freecores/RISCMCU/(list of files, cad)

Other CAD files:
asm/game.obj
asm/calc.obj
