freecores/RISCMCU/documentation/RISCMCU_Presentation.pdf

# Building A RISC Microcontroller in an FPGA

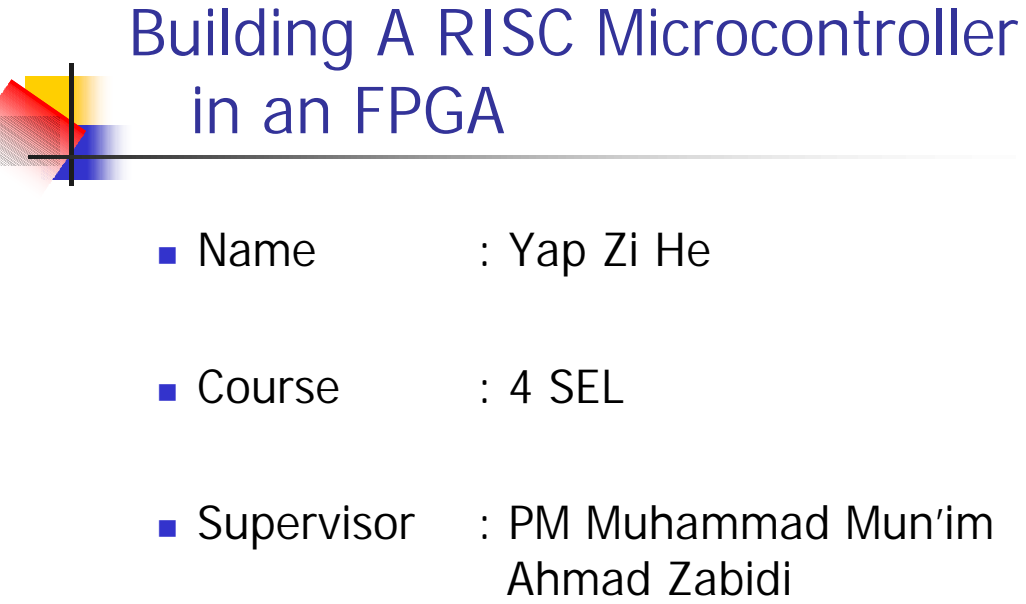
[picture p15: page 1]
n Name; : Yap Zi He; n Course; : 4 SEL; Ahmad Zabidi

n Supervisor : PM Muhammad Mun’im

# Introduction

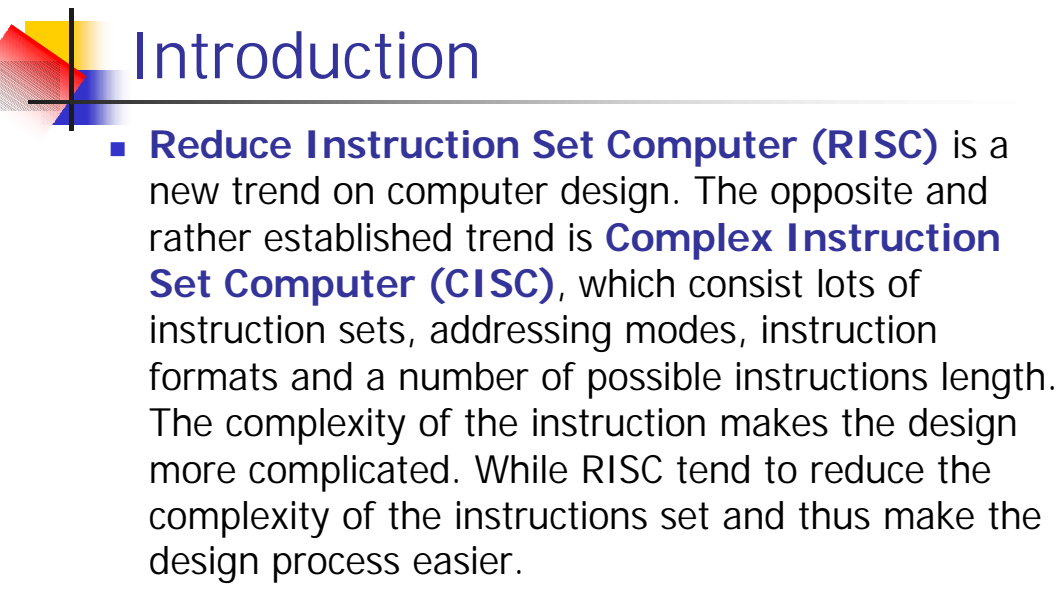
[picture p16: page 2]

n Reduce Instruction Set Computer (RISC) is a
new trend on computer design. The opposite and
rather established trend is Complex Instruction
Set Computer (CISC), which consist lots of
instruction sets, addressing modes, instruction
formats and a number of possible instructions length.
The complexity of the instruction makes the design
more complicated. While RISC tend to reduce the
complexity of the instructions set and thus make the
design process easier.

# Objectives

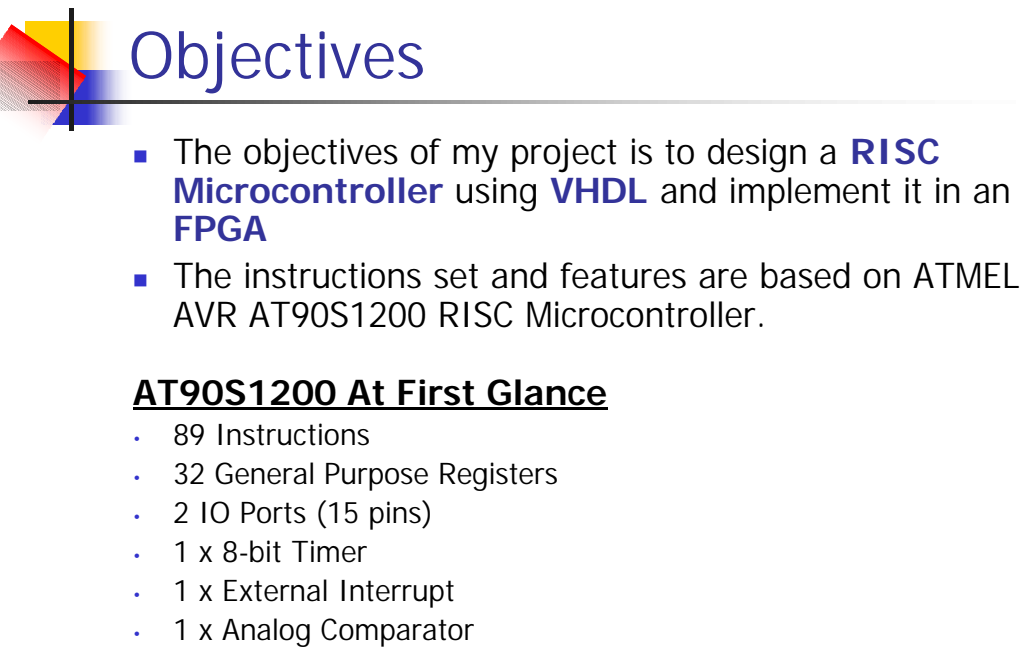
[picture p17: page 3]

n The objectives of my project is to design a RISC
Microcontroller using VHDL and implement it in an
FPGA
n The instructions set and features are based on ATMEL
AVR AT90S1200 RISC Microcontroller.
AT90S1200 At First Glance
• 89 Instructions
• 32 General Purpose Registers
• 2 IO Ports (15 pins)
• 1 x 8-bit Timer
• 1 x External Interrupt
• 1 x Analog Comparator

# Scopes

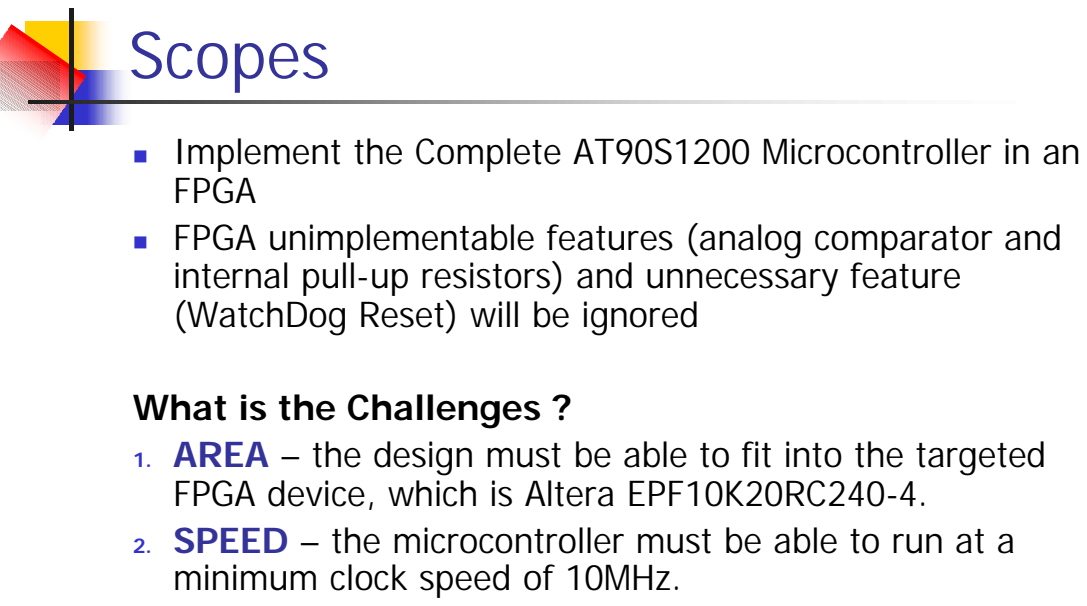
[picture p18: page 4]

n Implement the Complete AT90S1200 Microcontroller in an
FPGA
n FPGA unimplementable features (analog comparator and
internal pull-up resistors) and unnecessary feature
(WatchDog Reset) will be ignored

What is the Challenges ?
1. AREA – the design must be able to fit into the targeted
FPGA device, which is Altera EPF10K20RC240-4.
2. SPEED – the microcontroller must be able to run at a
minimum clock speed of 10MHz.

# Project Background

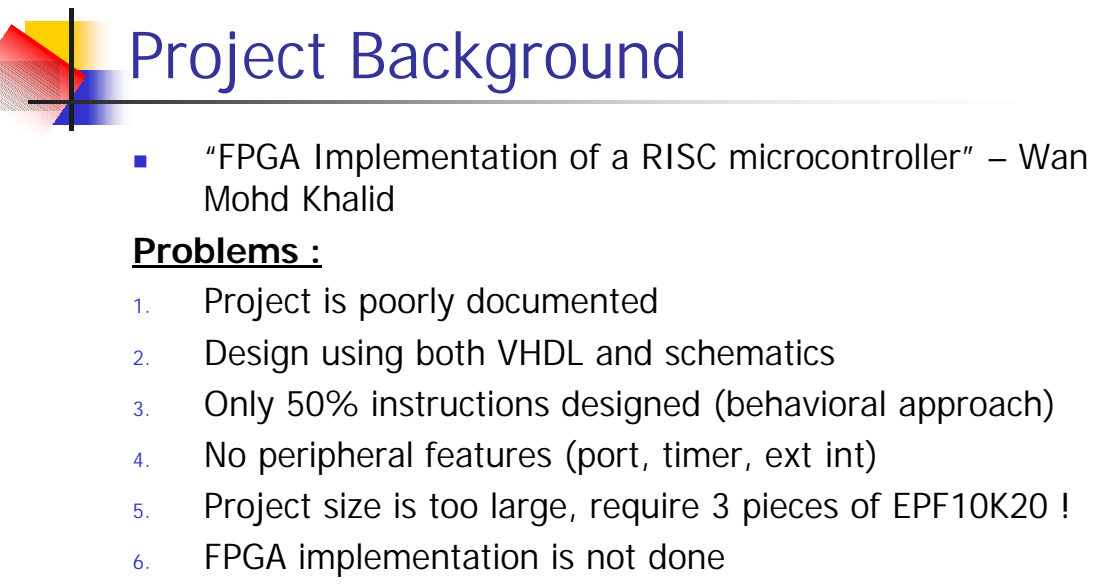
[picture p19: page 5]

“FPGA Implementation of a RISC microcontroller” – Wan
Mohd Khalid
Problems :
1. Project is poorly documented
2. Design using both VHDL and schematics
3. Only 50% instructions designed (behavioral approach)
4. No peripheral features (port, timer, ext int)
5. Project size is too large, require 3 pieces of EPF10K20 !
6. FPGA implementation is not done

## Approach

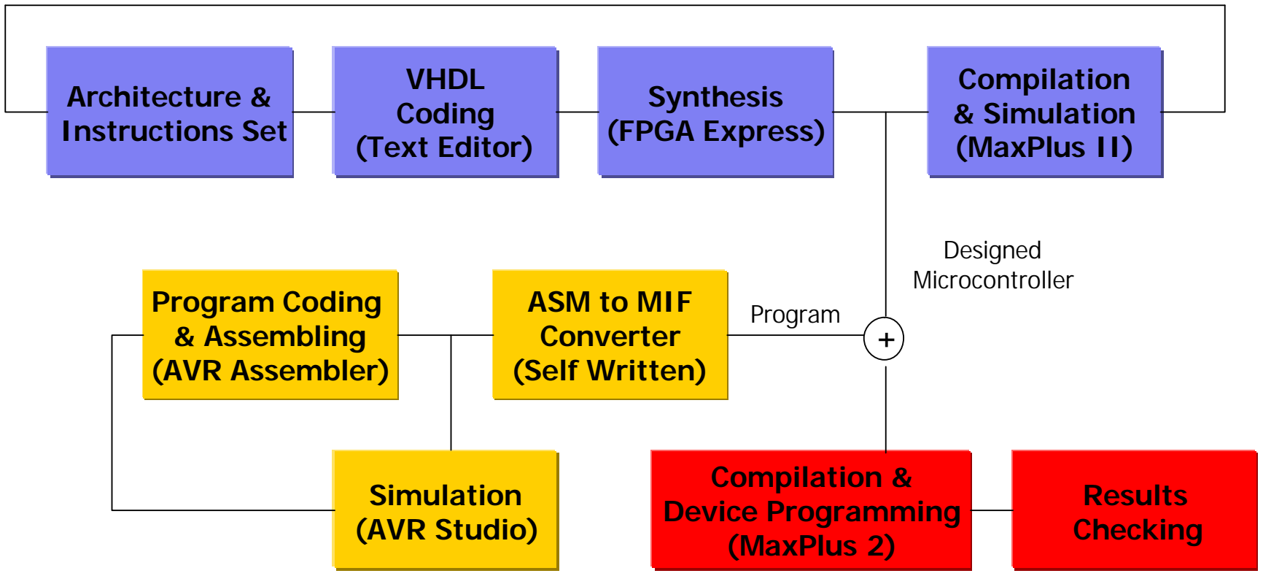
[picture p20: figure]
Architecture & Instructions Set; VHDL Coding (Text Editor); Synthesis (FPGA Express); Compilation & Simulation (MaxPlus II); Program Coding & Assembling (AVR Assembler); ASM to MIF Converter (Self Written); Compilation & Device Programming (MaxPlus 2); Results Checking; Simulation (AVR Studio); Program; Designed Microcontroller

Hardware Implementation

Software (VHDL)

# Architecture Overview

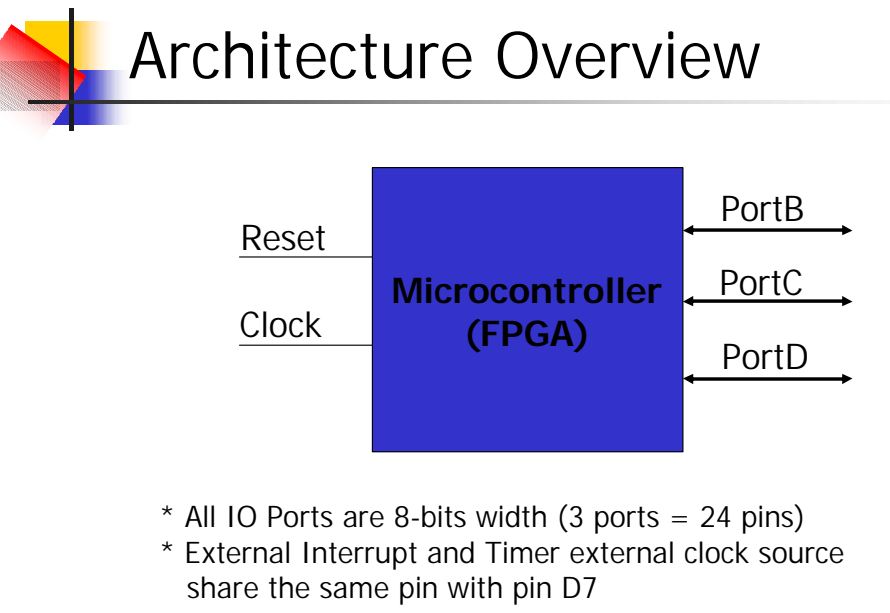
[picture p21: page 7]
Microcontroller (FPGA); Reset; Clock; PortB; PortC; PortD

* All IO Ports are 8-bits width (3 ports = 24 pins)
* External Interrupt and Timer external clock source
share the same pin with pin D7

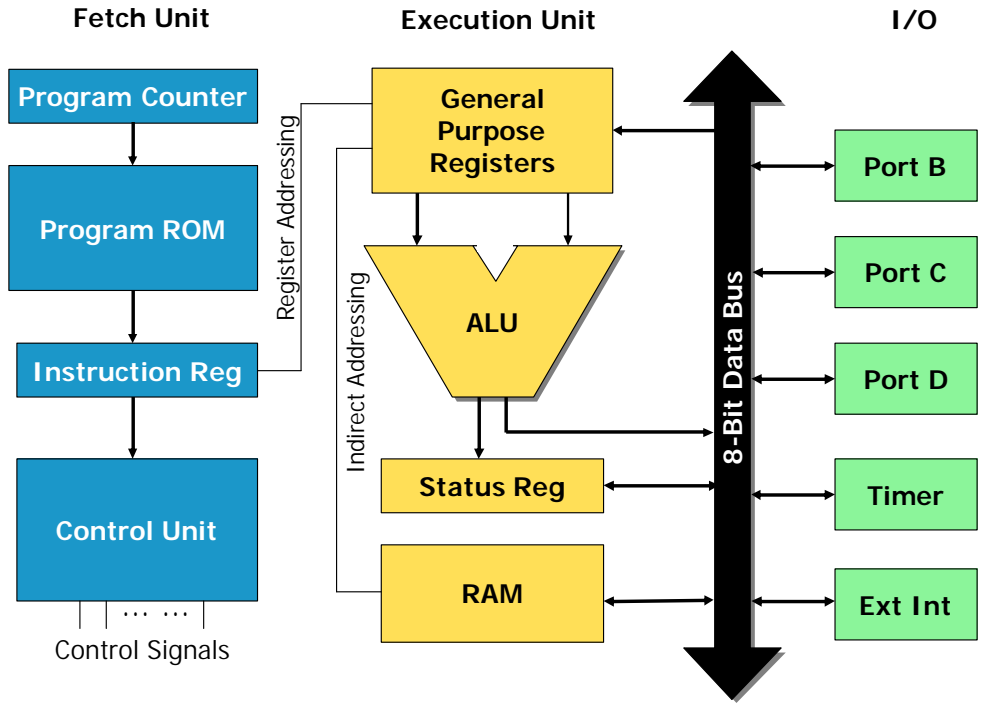
[picture p22: page 8]
Program Counter; Program ROM; Control Unit; Port B; Port C; Port D; Timer; General Purpose Registers; Status Reg; RAM; ALU; Fetch Unit; Execution Unit; I/O 8⁻Bit Data Bus … …; Control Signals; Indirect Addressing; Register Addressing

Instruction Reg Reg

Ext Ext Int Int

# Instructions Cycle / Pipelines

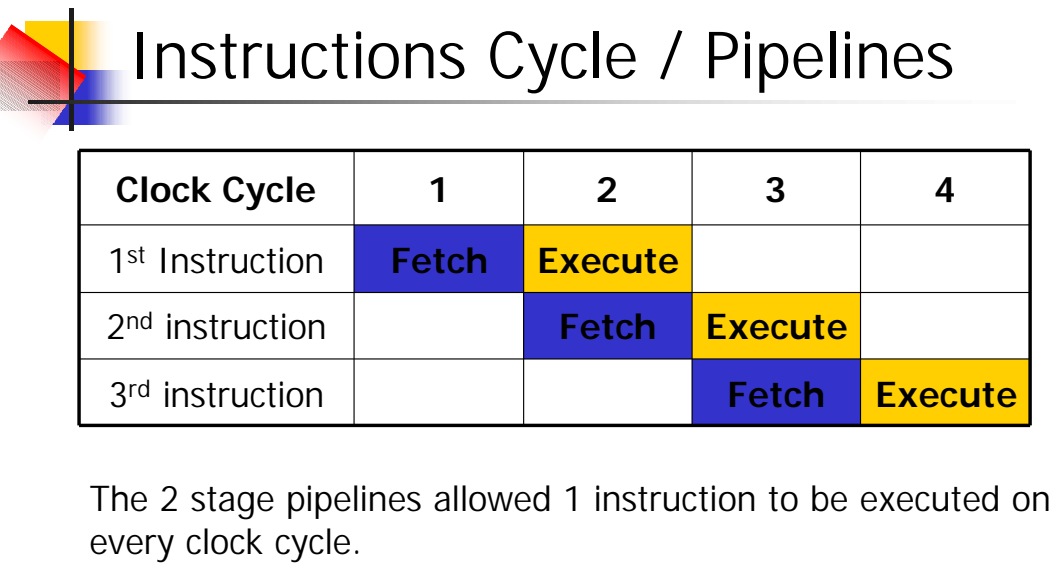
[picture p23: page 9]

Clock Cycle | 1 | 2 | 3 | 4
1 st Instruction | Fetch | Execute
2 nd instruction | | Fetch | Execute
3 rd instruction | | | Fetch | Execute

The 2 stage pipelines allowed 1 instruction to be executed on
every clock cycle.

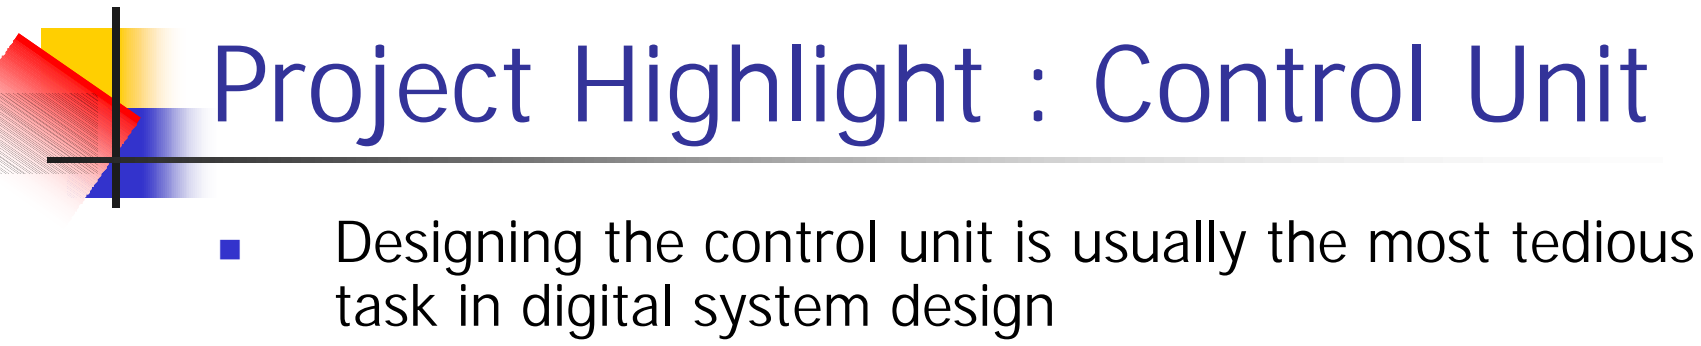
[picture p24: figure]
Project Highlight : Control Unit; task in digital system design

n | Designing the control unit is usually the most tedious
n | In my design, the control unit is implemented with Synchronous Mealy Model.
n | The advantages are :-
1. The control signals are asserted according to clock transition
| rather than generated by the state as in Moore Model. Thus the control signals appear faster and will speed up the microcontroller.
2. The control unit for the microcontroller has only 8 states ! This
| is because control signals are lock to transition rather than the states. So all single cycle instructions can share the same state.

## What is Synchronous Mealy Model ?

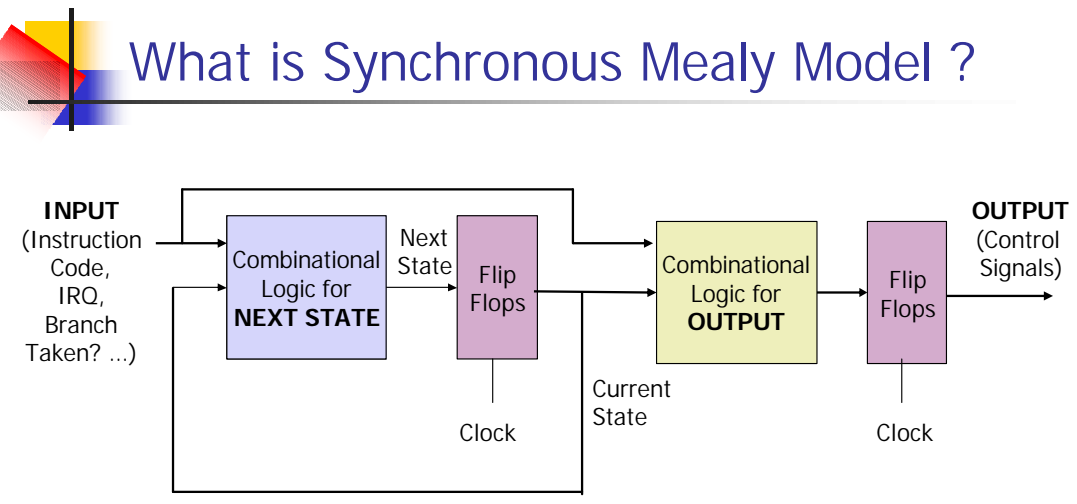
[picture p25: page 11]
Combinational Logic; Flip Flops; Combinational Logic for NEXT STATE; Combinational Logic for OUTPUT; Clock; INPUT (Instruction Code, IRQ, Branch Taken? …); OUTPUT (Control Signals); Current State; Next State

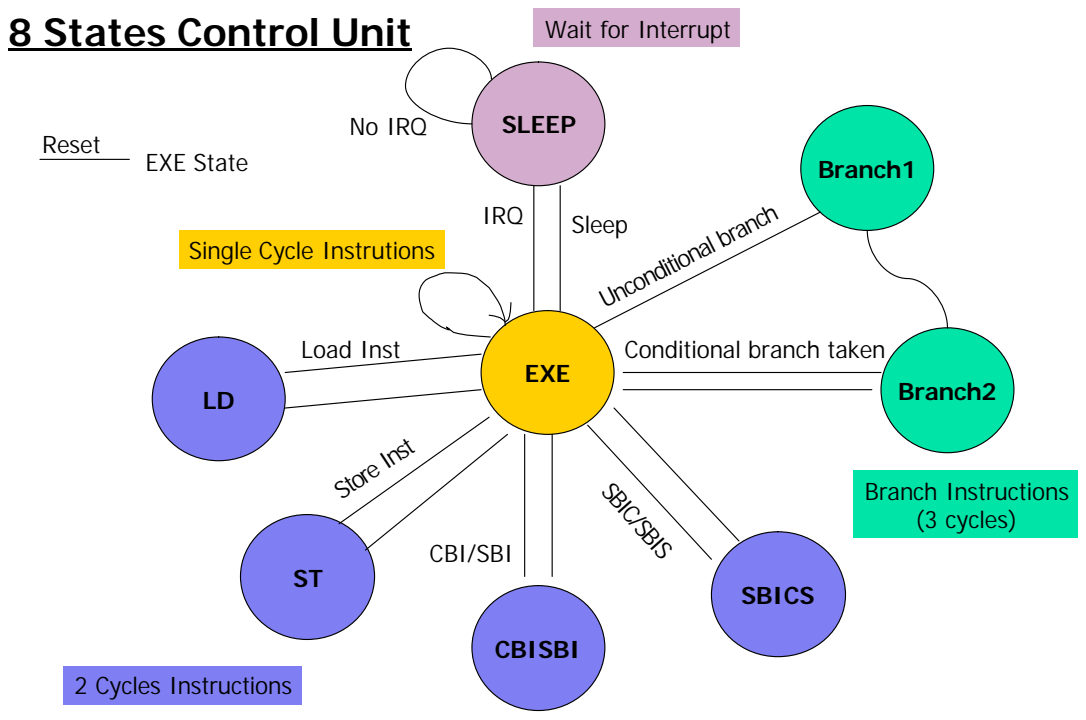
[picture p26: page 12]
EXE; CBISBI; SBICS; Branch1; Branch2; SLEEP; Load Inst; Store Inst; Unconditional branch; IRQ; No IRQ; Sleep; CBI/SBI; SBIC/SBIS; Reset; EXE State; 2 Cycles Instructions; Branch Instructions (3 cycles)

8 States Control Unit

Wait for Interrupt

Single Cycle Instrutions

Conditional branch taken

# Instructions

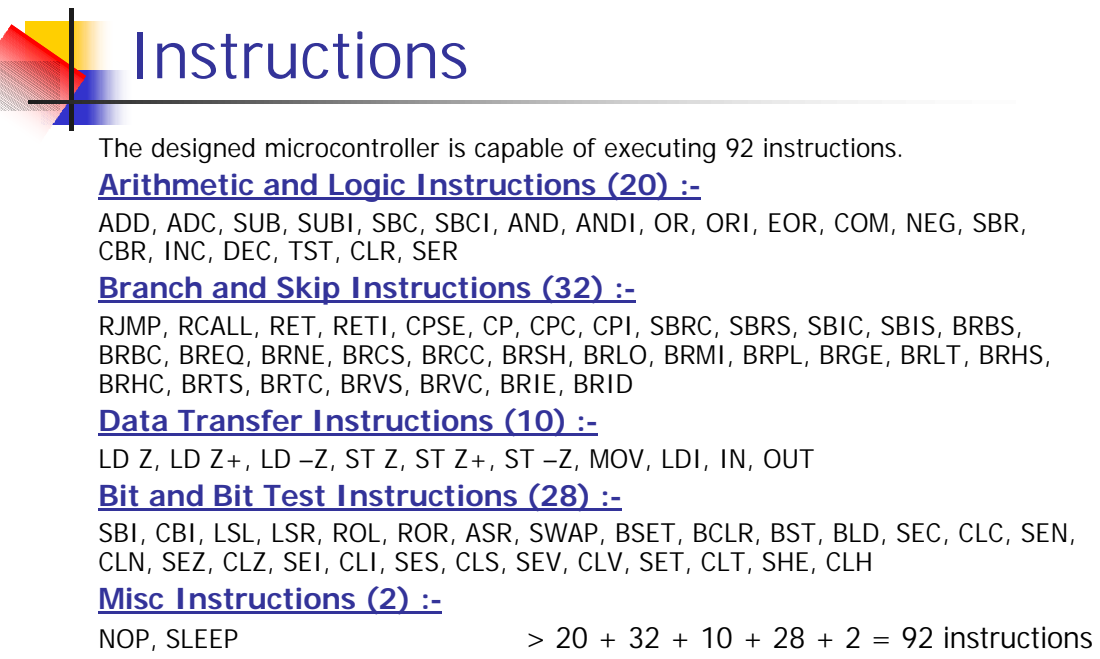
[picture p27: page 13]
NOP, SLEEP; > 20 + 32 + 10 + 28 + 2 = 92 instructions

The designed microcontroller is capable of executing 92 instructions.
Arithmetic and Logic Instructions (20) :-
ADD, ADC, SUB, SUBI, SBC, SBCI, AND, ANDI, OR, ORI, EOR, COM, NEG, SBR,
CBR, INC, DEC, TST, CLR, SER
Branch and Skip Instructions (32) :-
RJMP, RCALL, RET, RETI, CPSE, CP, CPC, CPI, SBRC, SBRS, SBIC, SBIS, BRBS,
BRBC, BREQ, BRNE, BRCS, BRCC, BRSH, BRLO, BRMI, BRPL, BRGE, BRLT, BRHS,
BRHC, BRTS, BRTC, BRVS, BRVC, BRIE, BRID
Data Transfer Instructions (10) :-
LD Z, LD Z+, LD –Z, ST Z, ST Z+, ST –Z, MOV, LDI, IN, OUT
Bit and Bit Test Instructions (28) :-
SBI, CBI, LSL, LSR, ROL, ROR, ASR, SWAP, BSET, BCLR, BST, BLD, SEC, CLC, SEN,
CLN, SEZ, CLZ, SEI, CLI, SES, CLS, SEV, CLV, SET, CLT, SHE, CLH
Misc Instructions (2) :-

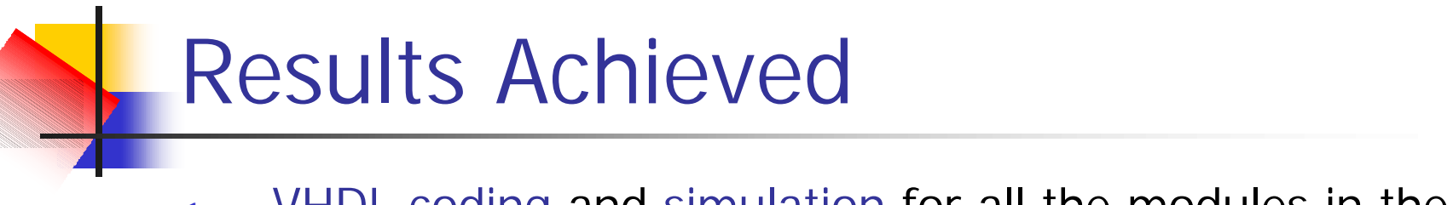
[picture p28: figure]
Results Achieved

1. VHDL coding and simulation for all the modules in the block diagram has been done successfully.
2. The design has been programmed into FPGA successfully.
3. The FPGA is now a microcontroller and is able to control some real applications (will be demo).

How about the challenges stated ?
AREA – The design fit into the targeted device successfully
(using 92% of EPF10K20RC240-4) SPEED – The final design clock speed is 12 MHz (target is 10MHz)

| AT90S1200 | RISCMCU
Instructions | 89 | 92
G.P Registers | 32 | 16
Program ROM | 512 words | 512 words
IO Ports | 2 (15 pins) | 3 (24 pins)
Addressing Modes | 5 | 8
Speed | 4 MHz / 12 MHz | 12 MHz*
8-bit Timer | 1 | 1
External Interrupt | 1 | 1
Analog Comparator | 1 | None
Implementation | CMOS | FPGA
SRAM | None | 128 bytes

## AT90S1200 VS My Design

* 18 MHz can be achieved when implemented in the fastest device from the same family

## Recommendations on Future Works

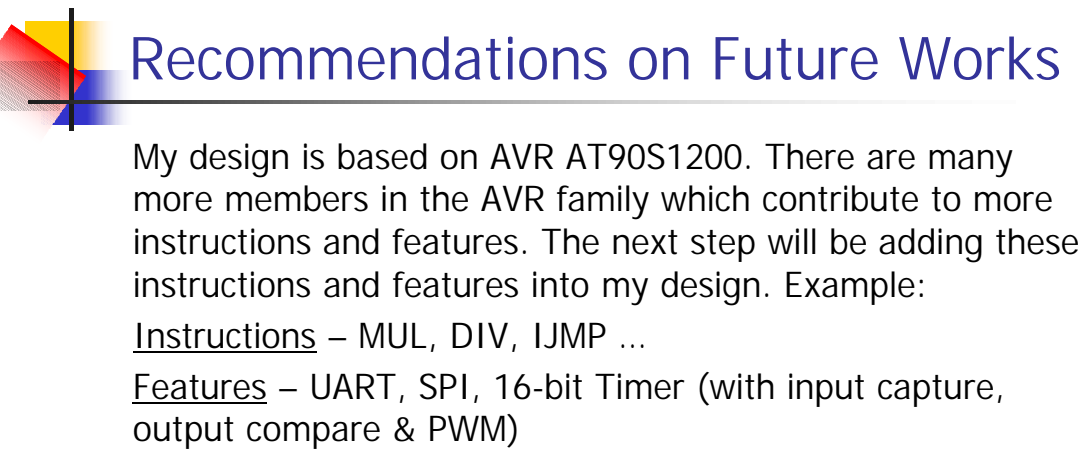
[picture p29: page 16]

My design is based on AVR AT90S1200. There are many
more members in the AVR family which contribute to more
instructions and features. The next step will be adding these
instructions and features into my design. Example:
Instructions – MUL, DIV, IJMP …
Features – UART, SPI, 16-bit Timer (with input capture,
output compare & PWM)

# Conclusion

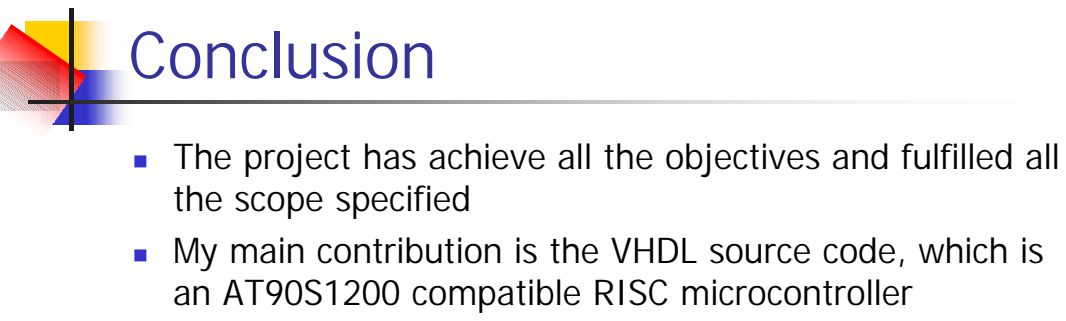
[picture p30: page 17]

n The project has achieve all the objectives and fulfilled all
the scope specified
n My main contribution is the VHDL source code, which is
an AT90S1200 compatible RISC microcontroller
