freecores/RISCMCU/(commit log)

2002-07-05 1. Remove the use of frequency divider 2. Uses the same external interrupt pin and timer external clock source pin as AT90S1200 3. Adds some comments to each module instantation.
2002-07-07 too many files
    [calc.obj, game.obj]
